EfraimManurung/instrumentation-system-fi2271/Laporan/sistem instrumentasi fix.pdf.docx

ALAT UKUR SUHU MENGGUNAKAN SENSOR THERMISTOR NTC BERBASIS MIKROKONTROLER ARDUINO UNO

Untuk memenuhi tugas Research Based Learning (RBL) mata kuliah FI2271 Sistem Instrumentasi

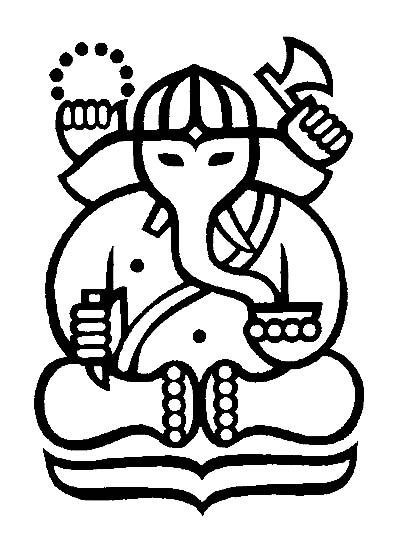
[picture p18: figure]

Anggi Maulana Adi S. | 10217040
Ahmad Al Ghiffari | 10217047
Efraim Partogi Nahotasi | 10217048

Program Studi Fisika

Fakultas Matematika dan Ilmu Pengethuan Alam Institut Teknologi Bandung

2018/2019

# Abstrak

Laporan Research Based Learning ini disusun dengan tujuan untuk menentukan rangkaian elektronika sistem kendali pemanas air beserta komponen yang menyusunnya. Metode yang digunakan dalam RBL ini memanfaatkan sensitifitas sensor thermistor NTC 10k terhadap perubahan suhu lingkungan disekitarnya. Selanjutnya didesain pengondisi sinyal sehingga menghasilkan keluaran 0-5V lalu dikonversi ke dalam sistem digital oleh mikrokontroler Arduino Uno. Sistem kontrol suhu menggunakan thermistor sebagai umpan balik dan heater sebagai plant system tersebut. Hasil dari percobaan RBL ini didapatkannya rangkaian yang bekerja dengan menyalakan heater sesuai dengan masukan suhu yang diberikan.

# Kata Kunci: Mikrokontroler, Heater, Pengondisi sinyal, PID, Termometer, Thermistor

# RANCANGAN BANGUN RANGKAIAN PENGONDISI SINYAL

Akan didesain dan dibangun alat ukur suhu dengan rentang suhu diantara 30 - 60 °C dan diperlukan sinyal tegangan keluaran dengan rentang 0 - 5V untuk dikonversi menjadi sinyal digital lalu diolah oleh mikrokontroler Arduino Uno. Untuk mendeteksi perubahan suhu lingkungan digunakan sensor thermistor NTC 10k yang dirangkai menjadi rangkaian jembatan dengan hambatan lainnya dengan nilai tertentu. Supply ke rangkaian jembatan ini diberikan oleh rangkaian pembagi tegangan antara sebuah resistor dan dioda zener 5.1V. Nilai resistor pada rangkaian jembatan dibuat sedemikian sehingga dihasilkan beda tegangan keluaran rangkaian jembatan sebesar 0 V pada suhu 30 °C. Untuk menguatkan sinyal keluaran dari rangkaian jembatan, digunakan penguat instrumentasi yang masuk ke mikrokontroler.

Pengolahan digital dilakukan oleh Arduino Uno. Dilakukan konversi sinyal analog ke sinyal digital (ADC) yang kemudian diolah untuk ditampilkan ke LCD; kontrol PID. PID diperlukan untuk mengatur daya pada plant pemanas (heater) sehingga suhu lingkungan (dalam hal ini air) dapat dipertahankan pada nilai titik acu (set point). Dalam kontrol suhu ini, mikrokontroler mendapatkan umpan balik (feedback) dari sensor.

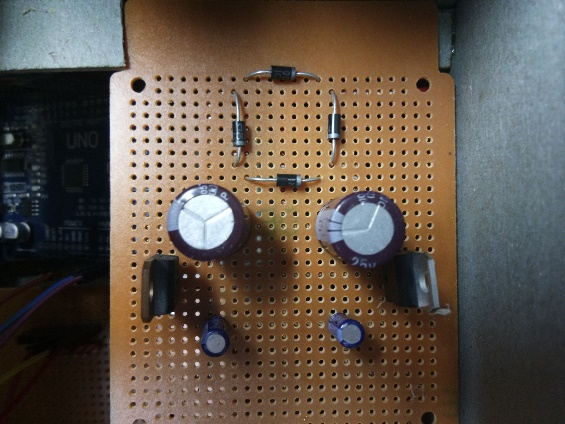
[picture p19: figure]

Gambar 1. Rangkaian Power Supply CT

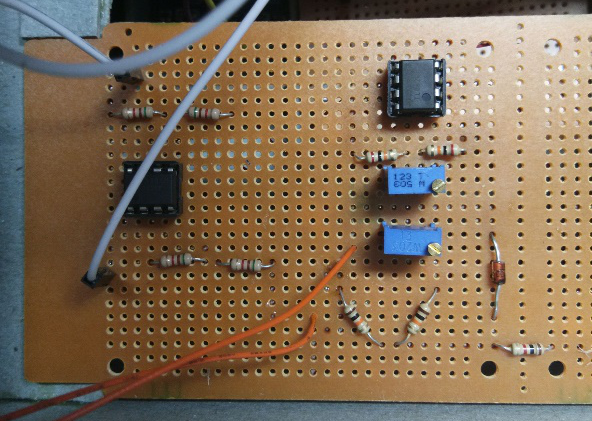
[picture p20: figure]

Gambar 2. Rangkaian Pengondisi Sinyal

# MODEL MATEMATIS RANGKAIAN SIGNAL CONDITIONING

Dalam rangkaian signal conditioning digunakan rangkaian jembatan dan penguat instrumentasi. Persamaan matematis pada rangkaian jembatan sebagai berikut.

Vb=(RPOTE)/(RPOTE+R2) Vreff (1)

Va=(RT)/(RT+R3)Vreff (2)

Dengan R2 = R3 dan mensubtitusikan persamaan 1 dan 2, diperoleh

Vab=Va-Vb=((RT)/(RT+R2)-(RPOTE)/(RPOTE+R2))Vreff (a)

Pada penguat Instrumentasi, persamaan matematis seperti berikut.

I1=(V1-Va)/(R4) (3)

I2=(Va-Vb)/(RPOT) (4)

I3=(Vb-V2)/(R5) (5)

Dari persamaan tersebut diperoleh I1 = I2 = I3, sehingga

I1=I2=I3=I=(Va-Vb)/(RPOT) (6)

Karena tidak ada arus yg masuk ke Op-Amp dan R4 = R5, maka

I=(V1-V2)/(2R4+RPOT)

V1-V2=I(2R4+RPOT) (7)

Substitusikan persamaan 6 dan 7, maka diperoleh

V1-V2=((2R4+RPOT))/(RPOT)(Va-Vb)

V1-V2=((2R4)/(RPOT)+1)(Va-Vb) (8)

Karena R4 = R5, maka dapat diperoleh

Vo=I (2R4+RPOT) (9)

Dengan melakukan substitusi pada persamaan 3 dan 4, diperoleh

Vo=(Vab)/(RPOT)(2R4+RPOT) (10)

Kemudian R6 = R7 = R8 = R9 dan pembagi tegangan, sehingga

(V+) =(V-)=(R6)/(R6+R6)V2=(V2)/2 (11)

I4 =(V1-(V-))/(R6)=(V1)/(R6)-(V2)/(2R6) (12)

I5 =((V-)-Vo)/(R6) (13)

Substitusikan persamaan 13 dan 11, diperoleh

I5 =(V2)/(2R6)-(Vo)/(R6) (14)

Kemudian karena I4 = I5, maka

(V1)/(R6)-(V2)/(2R6)=(V2)/(2R6)-(Vo)/(R6)

Vo=V2-V1 (15)

Selanjutnya substitusikan persamaan 15 dan 8, maka diperoleh

Vo=((2R4)/(RPOT)+1)(Vb-Va) (b)

# SKEMATIK RANGKAIAN

Penguat Instrumentasi yang digunakan yaitu TL082 dengan nilai Vcc masukan sebesar + 12 V. Heater dikontrol menggunakan PID dari Arduino Uno. Fitur hardware yang digunakan yaitu tampilan LCD dan pengatur suhu set (keypad).

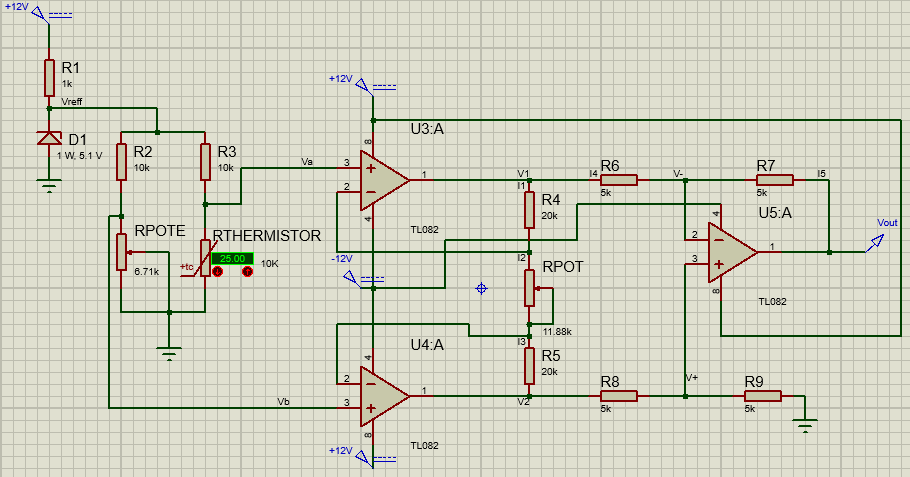
[picture p21: figure]

Gambar 3. Rangkaian menggunakan Thermistor NTC

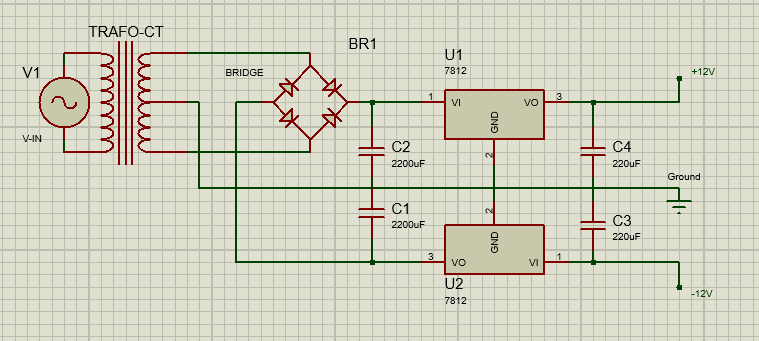
[picture p22: figure]

Gambar 4. Rangkaian Power Supply CT

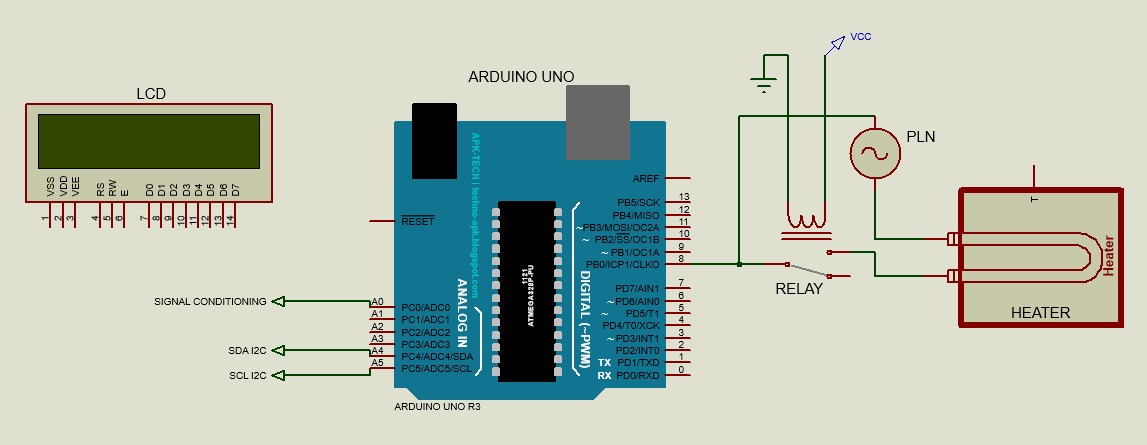
[picture p23: figure]

Gambar 5. Rangkaian Pin pada LCD I2C dan Plant dengan Arduino Uno.

# HASIL KALIBRASI SENSOR SUHU

Sensor thermistor NTC 10k dilakukan kalibrasi antara suhu terhadap nilai resistansi.

Tabel 1. Nilai Kalibrasi Suhu terhadap Resistansi pada Sensor NTC 10k

T (⁰C) | R (kꭥ) | T (⁰C) | R (kꭥ) | T (⁰C) | R (kꭥ)
30 | 9.95 | 40 | 6.77 | 50 | 4.72
31 | 9.52 | 41 | 6.59 | 51 | 4.55
32 | 9.26 | 42 | 6.31 | 52 | 4.4
33 | 8.98 | 43 | 6.09 | 53 | 4.24
34 | 8.5 | 44 | 5.85 | 54 | 4.1
35 | 8.33 | 45 | 5.77 | 55 | 3.92
36 | 7.94 | 46 | 5.44 | 56 | 3.75
37 | 7.55 | 47 | 5.24 | 57 | 3.7
38 | 7.31 | 48 | 5.11 | 58 | 3.564
39 | 7.09 | 49 | 4.9 | 59 | 3.43
| | | | 60 | 3.318

Selanjutnya dengan melakukan plot pada tabel 1, diperoleh persamaan hasil regresi nilai resistansi terhadap suhu sebagai berikut:

T = 0.3976(R)² - 9.6034(R) + 86.801

Gambar 6. Grafik Kalibrasi Suhu terhadap Resistansi pada Sensor suhu NTC 10k

# HASIL PENGUKURAN KELUARAN

Setelah sensor suhu telah terkalibrasi, kemudian dilakukan kalibrasi pada rangkaian bridge dan pengondisi sinyal. Dengan menentukan nilai resistansi sedemikian rupa pada rangkaian bridge dan pengondisi sinyal, diperoleh nilai tegangan keluaran terhadap suhu pada PCB sebagai berikut.

Tabel 2. Nilai Tegangan Keluaran pada Rangkaian Bridge di PCB

Suhu | Nilai | Suhu | Nilai | Suhu | Nilai
T ( °C ) | Vout (V) | T ( °C ) | Vout (V) | T ( °C ) | Vout (V)
29 | 0.06 | 40 | 0.63 | 51 | 0.99
30 | 0.2 | 41 | 0.67 | 52 | 1.01
31 | 0.26 | 42 | 0.71 | 53 | 1.03
32 | 0.32 | 43 | 0.73 | 54 | 1.06
33 | 0.34 | 44 | 0.75 | 55 | 1.09
34 | 0.41 | 45 | 0.74 | 56 | 1.11
35 | 0.42 | 46 | 0.82 | 57 | 1.17
36 | 0.41 | 47 | 0.83 | 58 | 1.18
37 | 0.39 | 48 | 0.87 | 59 | 1.2
38 | 0.45 | 49 | 0.89 | 60 | 1.22
39 | 0.58 | 50 | 0.96

## Gambar 7. Grafik Suhu Terhadap Tegangan Keluaran pada rangkaian bridge

Tabel 3. Nilai Tegangan Keluaran pada Rangkaian Pengondisi sinyal di PCB

Suhu | Nilai | Suhu | Nilai | Suhu | Nilai
T ( °C ) | Vout (V) | T ( °C ) | Vout (V) | T ( °C ) | Vout (V)
30 | 0.14 | 41.1 | 2.17 | 50.8 | 3.71
30.3 | 0.21 | 41.3 | 2.17 | 51.1 | 3.75
30.6 | 0.32 | 41.5 | 2.23 | 51.4 | 3.81
31.2 | 0.46 | 41.7 | 2.28 | 51.7 | 3.88
31.8 | 0.54 | 42.1 | 2.38 | 52 | 3.95
32.4 | 0.62 | 42.5 | 2.45 | 52.4 | 4.06
32.8 | 0.69 | 42.7 | 2.52 | 52.8 | 4.11
33.1 | 0.81 | 43.2 | 2.55 | 53.2 | 4.16
33.7 | 0.92 | 43.5 | 2.57 | 53.6 | 4.19
34 | 0.95 | 43.7 | 2.61 | 52.9 | 4.23
34.1 | 0.97 | 44.1 | 2.64 | 54.1 | 4.21
34.3 | 1 | 44.4 | 2.69 | 54.4 | 4.22
34.6 | 1.04 | 44.6 | 2.78 | 54.8 | 4.28
34.8 | 1.13 | 45.1 | 2.83 | 55 | 4.31
35.2 | 1.19 | 45.5 | 2.96 | 55.3 | 4.33
35.6 | 1.24 | 45.9 | 3.04 | 55.6 | 4.4
35.9 | 1.32 | 46.3 | 3.08 | 55.9 | 4.5
36.2 | 1.42 | 46.5 | 3.08 | 56.2 | 4.51
36.6 | 1.5 | 46.7 | 3.13 | 56.5 | 4.56
37.1 | 1.59 | 47.1 | 3.18 | 56.9 | 4.61
37.6 | 1.66 | 47.4 | 3.21 | 57.3 | 4.7
37.9 | 1.61 | 47.6 | 3.23 | 57.6 | 4.82
38.1 | 1.64 | 47.9 | 3.26 | 58 | 4.85
38.3 | 1.69 | 48.3 | 3.36 | 58.3 | 4.79
38.6 | 1.77 | 48.7 | 3.45 | 58.5 | 4.78
38.9 | 1.85 | 49 | 3.49 | 58.6 | 4.81
39.3 | 1.94 | 49.3 | 3.5 | 58.8 | 4.86
39.6 | 1.96 | 49.5 | 3.52 | 59 | 4.82
39.9 | 2.04 | 49.8 | 3.55 | 59.5 | 4.87
40.2 | 2.14 | 50 | 3.59 | 59.8 | 4.99
40.6 | 2.18 | 50.4 | 3.63 | 60.2 | 5.07

Selanjutnya dengan melakukan plot pada tabel 3, diperoleh persamaan suhu terhadap tegangan keluaran sebagai berikut:

## Gambar 8. Grafik Suhu Terhadap Tegangan Keluaran pada rangkaian pengondisi sinyal

## Gambar 9. Grafik Tegangan Keluaran Terhadap Suhu

# Plot Kenaikan Suhu terhadap Waktu dengan Nilai Kp 1.0

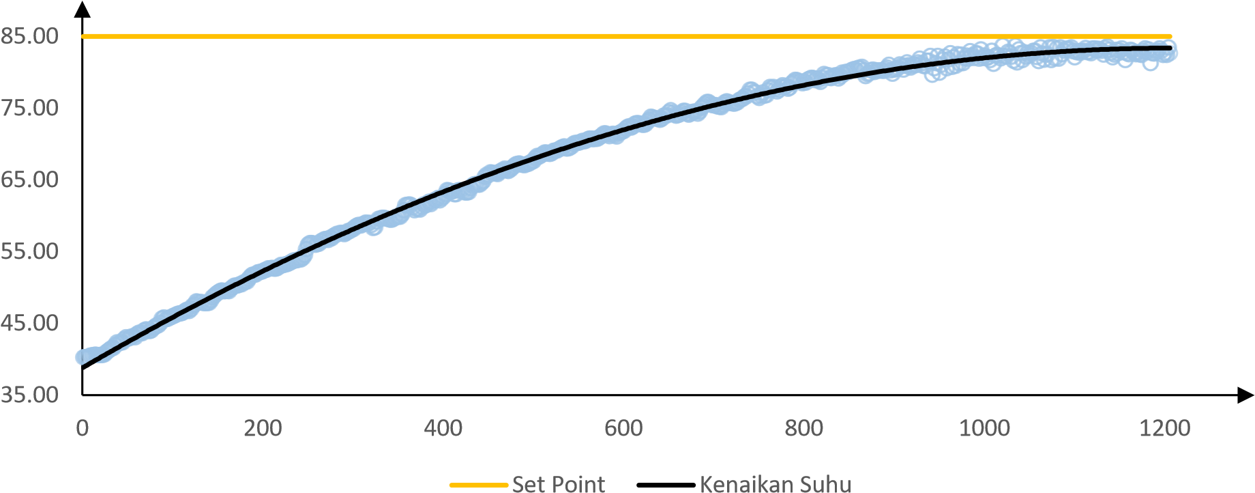
[picture p24: figure]

Gambar 10. Grafik suhu terhadap waktu

## Gambar 9. Grafik Temperatur terhadap waktu pada setpoint 35

## Gambar 9. Grafik Temperatur terhadap waktu pada setpoint 45

## Gambar 9. Grafik Temperatur terhadap waktu pada setpoint 55

Ketika melakukan pemanasan dan di set Kp, Ki, Kd, berturut-turut sebesar 1.0, 0.0, 0.0. tidak terjadi overshoot, namun suhu terukur tidak mencapai suhu acuan (suhu set), suhu terukur maksimum sebesar 83.34°C dari 85°C suhu yang dijadikan acuan. Nilai suhu terukur tersebut tercapai dalam waktu 1209 sekon dengan volume air sebesar 700 mL.

## ANALISIS

Analisis saat eksperimen PID dengan berbagai nilai Kp,Ki dan Kd dengan nilai window size yaitu sama sebesar 2000. Untuk yang pertama yaitu membuat setpoint pada 35 derajat celcius dan harus membuat error steady state nya dibawah 5% atau ± 1.75 derajat celcius dari hasil percobaan yang didapatkan nilai error steady state paling baik saat nilai Kp = 8 dan Kd = 0.5 yaitu sebesar 3.7% atau ± 1.3 derajat celcius. Untuk nilai Kp = 8 tanpa Kd didapatkan overshot begitu besar hingga berbeda 3 derajat celcius dari nilai setpoint, saat nilai Kp = 6 tanpa Kd didapatkan tidak pernah mencapai overshot. Untuk yang kedua yaitu setpoint pada 45 derajat celcius dan harus membuat error steady state nya dibawah 5% atau ± 2.25 derajat celcius dari hasil percobaan yang didapatan nilai error steady state paling baik saat nilai Kp = 7, Ki = 0.1 dan Kd = 0.5 yaitu sebesar 3.3% atau ± 1.485 derajat celcius. Saat nilai Kp = 9,Ki = 0.1 dan Kd = 1 akan terjadi overshot sebesar 3 derajat yang berarti sudah diluar batas error steady state dan saat nilai Kp = 7.5 Ki =0.1 dan Kd = 0.5 nilai temperatur akan diam pada nilai 47. Untuk yang ketiga yaitu setpoint pada 55 derajat celcius dan harus membaut error steady state nya dibawah 5% atau ± 2.75 derajat celcius, dari hasil percobaan didapatkan nilai paling error steady state paling baik saat Kp = 15,5 Ki =0.5 dan Kd = 1 dengan nilai error steady state sebesar 1.69% atau ± 0.93 derajat celcius. Untuk variasia nilai lain Kp = 14 Ki = 0.5 dan Kd = 1 didapatkan nilai overshot sebesar 3 derajat celcius dengan waktu rise time yang cukup lama, lalu dengan percobaan yang lain dengan Kp = 16 terdapat fluktuasi nilai temperatur yang sangat tinggi dan juga tidak mencapai nilai setpoint.

Dari hasil kalibrasi pada pengondisi sinyal, nilai tegangan keluaran menggunakan proteus berbeda dengan tegangan keluaran yang sebenarnya. Ketika 40°C nilai tegangan keluaran bernilai negatif dan ketika 85°C nilai tegangan keluaran lebih dari 5 V yang artinya hasil keluaran tidak terbaca oleh program Arduino Uno. Nilai tegangan keluaran ditampilkan pada LCD hanya pada suhu antara 40°C – 86°C, nilai ini didapatkan karena dilakukan perubahan nilai konstanta pada persamaan (c) di dalam source code Arduino. Hal ini disebabkan oleh tegangan masukan yang diberikan dari dioda zener yang berfluktuasi pada nilai 5,12 – 5,20 V. Selain itu, ketika melakukan kalibrasi, kecepatan pembacaan voltmeter berbeda dengan kalibrator yang digunakan saat suhu naik dari 40°C, bacaan pada voltmeter berubah lebih lambat dibanding kalibrator suhu.

Nilai akurasi suhu yang ada di tampilan LCD dengan tampilan kalibrator berbeda + 0.5°C (rentang ini merupakan selisih nilai alat ukur dengan kalibrator; disebabkan karena ketelitian kalibrator hanya 1°C) dengan nilai di tampilan LCD lebih besar dibandingkan dengan di tampilan kalibrator. Kesamaan nilai tampilan alat ukur dengan kalibrator berkurang saat suhu mendekati titik acu yang digunakan.

## KESIMPULAN

Dari hasil percobaan pada variasi nilai yang digunakan pada PID untuk nilai setpoint kecil seperti rentang 30 hingga 35 cukup susah untuk mencapai nilai steady state error dibawah 5% dikarenakan nilai skala yang cukup kecil yaitu hanya sebesar 5 derajat celcius dari hasil eksperimen didapatkan sebesar 3.7% , untuk set point 45 didapatkan nilai steady state error sebesar 3.3% , dan yang terakhir untuk setpoint 55 derajat celcius dengan skala yang cukup besar maka bisa didapatkan nilai error steady state semakin baik dari hasil eksperimen didapatkan sebesar 1.69%.

Telah dibuat alat ukur suhu menggunakan sensor thermistor NTC 10 kΩ, alat ini bekerja pada rentang suhu sebesar 30°C - 60°C. Galat suhu antara alat ukur dengan kalibrator sebesar ± 0.5°C. Ketika nilai Kp, Ki, Kd diatur dengan nilai berturut-turut 1.0, 0.0, dan 0.0 dengan titik acu 85 °C didapatkan nilai maksimum yang terbaca oleh alat ukur adalah 83.34°C dengan rentang waktu selama 1209 sekon. Dari hasil uji alat ukur suhu diperoleh nilai akurasi sebesar 0.38°C/V.

## REFERENSI

[1] Anonim. TT. Thermistor. https://www.thermistor.com/thermistors. Diakses pada 16 April 2019 jam 09.28 WIB.
[2] Anonim. TT. Thermistors. https://www.electronics (https://www.electronics-tutorials.ws/io/thermistors.html)- (https://www.electronics-tutorials.ws/io/thermistors.html)tutorials.ws/io/thermistors.html. (https://www.electronics-tutorials.ws/io/thermistors.html) Diakses pada 16 April 2019 jam 09.30 WIB.
[3] Justin Bauer. 2015. Design of an Instrumentation Amplifier. [pdf]. https://www.electronics (https://www.electronics-tutorials.ws/io/thermistors.html) (https://www.electronics-tutorials.ws/io/thermistors.html)tutorials.ws/io/thermistors.html. (https://www.electronics-tutorials.ws/io/thermistors.html) Diunduh pada 15 April 2019 jam 09. 40 WIB.
[4] Prof. Katherine Chandler. 2012. Operational Amplifiers (Op Amps). [pdf]. www.eng.hmc.edu/NewE80/PDFs/Lecture%205%20- (http://www.eng.hmc.edu/NewE80/PDFs/Lecture%205%20-%20Op%20Amps.pdf)%20Op%20Amps.pdf (http://www.eng.hmc.edu/NewE80/PDFs/Lecture%205%20-%20Op%20Amps.pdf) (http://www.eng.hmc.edu/NewE80/PDFs/Lecture%205%20-%20Op%20Amps.pdf). Diakses pada 12 April 2018.
[5] Anonim. TT. Arduino Uno. http://www.tuxti.com.br/wiki/index.php?title=Arquivo:CircuitoArduino-i2c-display-lcd-16x2.png. Diakses pada 16 April 2018 jam 14.24 WIB.

## Daftar Simbol

R1 = 1 kΩ

R2 = R3 = 2 kΩ

RPOTE = 6,71 kΩ

R4 = R5 = 20 kΩ

RPOT = 11,88 kΩ

R6 = R7 = R8 = R9 = 5 kΩ

RT | = Resistansi pada Thermistor NTC 10K (Ω)
Va | = Tegangan yang ada di titik antara RT dan R3 (V)
Vb | = Tegangan yang ada di titik antara RPOT dan R2 (V)
V1 | = Tegangan yang ada di titik antara R4 dan R6 (V)
V2 | = Tegangan yang ada di titik antara R5 dan R8 (V)
Vo | = Tegangan keluaran (V)

## LAMPIRAN

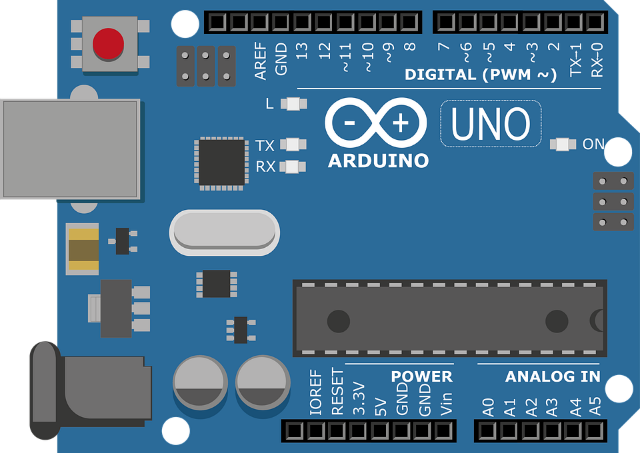
[picture p25: figure]

Gambar 11. Arduino Uno

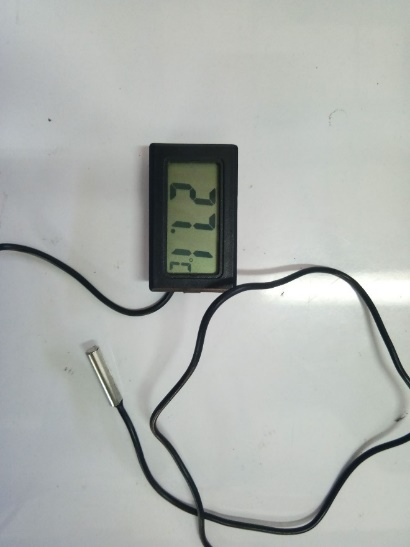
[picture p26: figure]

Gambar 12. Termometer

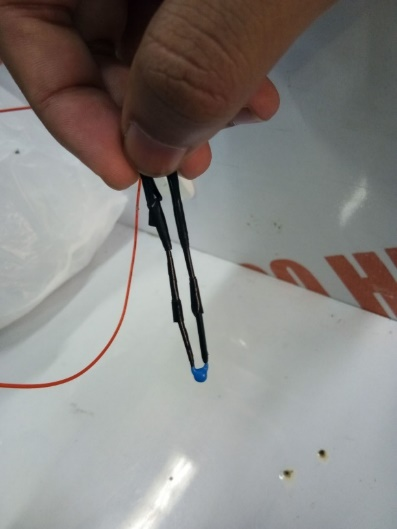
[picture p27: figure]

Gambar 13. Thermistor NTC 10k

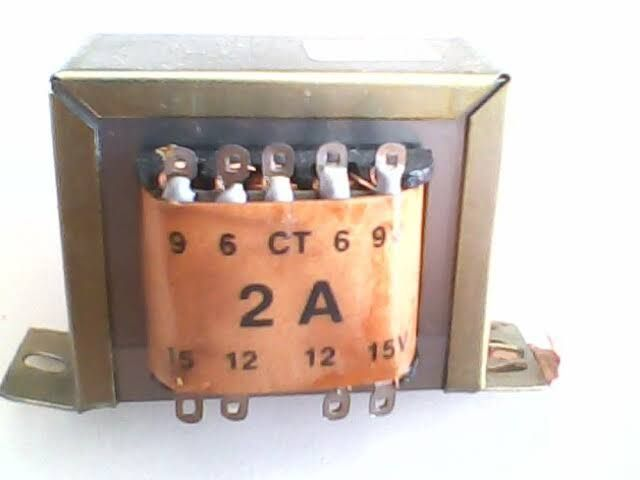
[picture p28: figure]

Gambar 14. Trafo CT

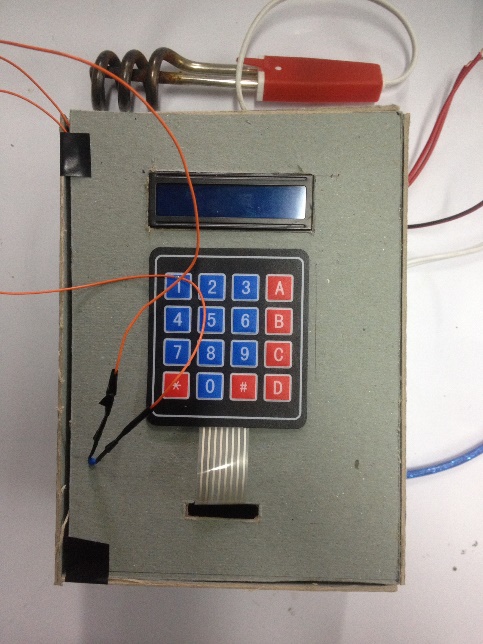
[picture p29: figure]

Gambar 15. Heater, LCD, keypad yang digunakan

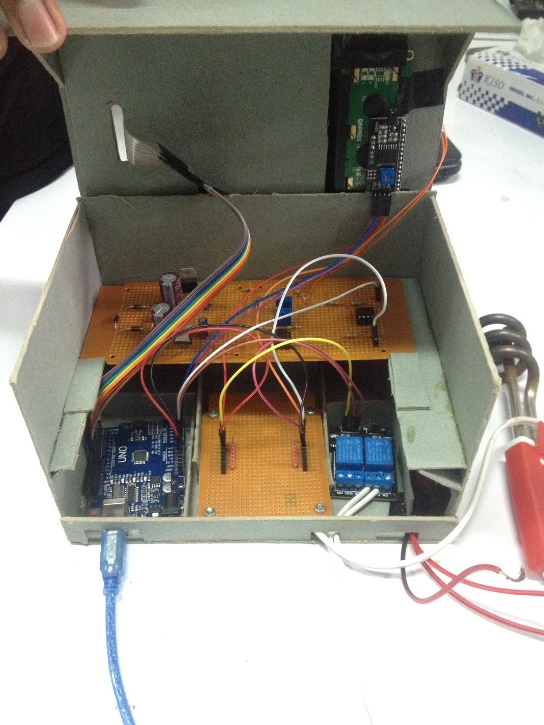
[picture p30: figure]

Gambar 16. Komponen yang terdapat didalam kotak

### Source Code Arduino Uno

// Deklarasi Library yang digunakan

#include <Wire.h>

#include <LiquidCrystal_I2C.h>

#include <Keypad.h>

#include <avr/pgmspace.h>

#include <PID_v1.h>

// Inisiasi variabel yang digunakan

const int sensorthermi = A0;

double resultPID;

double tempc;

double temps;

float Ton, Toff;

char InTemp[2];

unsigned long previousMillis1 = 0;

unsigned long previousMillis2 = 0;

unsigned long previousMillis3 = 0;

unsigned long previousMillis4 = 0;

const long interval1 = 2000;

const long interval2 = 2000;

const long interval3 = 500;

const long interval4 = 1000;

unsigned long PTexcel, PTdisplay, PTmeasure = 0;

unsigned long CTexcel, CTdisplay, CTmeasure = 0;

unsigned long ITexcel = 1000;

unsigned long ITdisplay = 666;

unsigned long ITmeasure = 100;

// SMOOTHING

const int numReadings = 10;

int readings[numReadings]; // the readings from the analog input

int readIndex = 0; // the index of the current reading

int total =0;

int average = 0; // the average

// Menginisiasi nilai lookup tabel dengan skala 0-5 V secara teoritik

const float ADC_TO_TEMP[1024] PROGMEM = {27.7555, 27.7859, 27.8164, 27.8469, 27.8773, 27.9078, 27.9382, 27.9687, 27.9992, 28.0296, 28.0601, 28.0906, 28.121, 28.1515, 28.1819, 28.2124, 28.2429, 28.2733, 28.3038, 28.3343, 28.3647, 28.3952, 28.4257, 28.4561, 28.4866, 28.517, 28.5475, 28.578, 28.6084, 28.6389, 28.6694, 28.6998, 28.7303, 28.7607, 28.7912, 28.8217, 28.8521, 28.8826, 28.9131, 28.9435, 28.974, 29.0044, 29.0349, 29.0654, 29.0958, 29.1263, 29.1568, 29.1872, 29.2177, 29.2482, 29.2786, 29.3091, 29.3395, 29.37, 29.4005, 29.4309, 29.4614, 29.4919, 29.5223, 29.5528, 29.5832, 29.6137, 29.6442, 29.6746, 29.7051, 29.7356, 29.766, 29.7965, 29.827, 29.8574, 29.8879, 29.9183, 29.9488, 29.9793, 30.0097, 30.0402, 30.0707, 30.1011, 30.1316, 30.162, 30.1925, 30.223, 30.2534, 30.2839, 30.3144, 30.3448, 30.3753, 30.4058, 30.4362, 30.4667, 30.4971, 30.5276, 30.5581, 30.5885, 30.619, 30.6495, 30.6799, 30.7104, 30.7408, 30.7713, 30.8018, 30.8322, 30.8627, 30.8932, 30.9236, 30.9541, 30.9845, 31.015, 31.0455, 31.0759, 31.1064, 31.1369, 31.1673, 31.1978, 31.2283, 31.2587, 31.2892, 31.3196, 31.3501, 31.3806, 31.411, 31.4415, 31.472, 31.5024, 31.5329, 31.5633, 31.5938, 31.6243, 31.6547, 31.6852, 31.7157, 31.7461, 31.7766, 31.807, 31.8375, 31.868, 31.8984, 31.9289, 31.9594, 31.9898, 32.0203, 32.0508, 32.0812, 32.1117, 32.1421, 32.1726, 32.2031, 32.2335, 32.264, 32.2945, 32.3249, 32.3554, 32.3858, 32.4163, 32.4468, 32.4772, 32.5077, 32.5382, 32.5686, 32.5991, 32.6296, 32.66, 32.6905, 32.7209, 32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
8.4622, 58.4927, 58.5231, 58.5536, 58.5841, 58.6145, 58.645, 58.6754, 58.7059, 58.7364, 58.7668, 58.7973, 58.8278, 58.8582, 58.8887, 58.9191}

;

// Alamat LCD

LiquidCrystal_I2C lcd(0x27,2,1,0,4,5,6,7,3, POSITIVE);

// Menginisiasi nilai kolom dan baris yang digunakan

const byte ROWS = 4; //Define amount of Rows

const byte COLS = 4; //Define amount of Columns

char hexaKeys[ROWS][COLS] = { //Define Keypad layout

{'1', '2', '3', 'A'},

{'4', '5', '6', 'B'},

{'7', '8', '9', 'C'},

{'*', '0', '#', 'D'}

};

byte rowPins[ROWS] = {9, 8, 7, 6}; //Pins for Keypad Input

byte colPins[COLS] = {5, 4, 3, 2};

Keypad myKeypad = Keypad(makeKeymap(hexaKeys), rowPins, colPins, ROWS, COLS);

// Setup for PID

double Setpoint, Input, Output;

double Kp=5.0, Ki=3.0, Kd=3.0;

const int Relay = A1;

PID myPID(&Input, &Output, &Setpoint, Kp , Ki, Kd, DIRECT);// Kpnya dulu dimainkan agar mendapatkan rise time yang paling cepat

//PID myPID(&Input, &output, &setpoint, Kp, Ki, Kd, Direction);

int WindowSize = 2000;

unsigned long windowStartTime;

void setup() {

Serial.begin(9600);

// Setup untuk PID

windowStartTime = millis();

myPID.SetOutputLimits(0, WindowSize);

myPID.SetMode(AUTOMATIC);

// Untuk smoothing

for (int thisReading = 0; thisReading < numReadings; thisReading++) {

readings[thisReading] = 0;}

// Menginisiasi LCD

lcd.begin(16,2);

lcd.backlight();

lcd.clear();

lcd.setCursor(0,0);

pinMode(A0, INPUT);

pinMode(A1, OUTPUT);

// Persiapan

lcd.print("READY");

}

void loop() {

unsigned long currentMillis1 = millis(); // Syarat agar keypad selalu dapat menerima nilai masukan

if (currentMillis1 - previousMillis1 >= interval1) { previousMillis1 = currentMillis1;

// Mencari nilai rata-rata masukan ADC

// subtract the last reading:

total = total - readings[readIndex];

// read from the sensor:

readings[readIndex] = analogRead(sensorthermi);

// add the reading to the total:

total = total + readings[readIndex];

// advance to the next position in the array:

readIndex = readIndex + 1;

// if we're at the end of the array...

if (readIndex >= numReadings) {

// ...wrap around to the beginning:

readIndex = 0;

}

// calculate the average:

average = total / numReadings;

// mengkonversi tegangan yang dibaca untuk ditampilkan pada serial monitor

float voltage = average * 5.0;

voltage /= 1024.0; }

// memunculkan nilai tegangan pada serial monitor

//Serial.print(voltage); Serial.println(" volts"); }

// PENGAMBILAN

// melakukan fungsi lookup table dengan data lookup tabel yang sudah dinisiasikan

unsigned long currentMillis2 = millis(); // Syarat agar keypad selalu dapat menerima nilai masukan

if (currentMillis2 - previousMillis2 >= interval2) { previousMillis2 = currentMillis2;

tempc = pgm_read_float_near (ADC_TO_TEMP + average);

Serial.println(tempc);//Serial.println(" derajat celcius"); // menulis nilai keluaran

//Serial.print("nilai bit rata-rata : "); Serial.println(average); // dimunculkan pada serial monitor

//Serial.println(); Serial.println();

//Serial.print(" temps : ");Serial.println(temps);

// MENAMPILKAN NILAI CURRENT TEMPERATURE DAN SET TEMPERATURE PADA DISPLAY

lcd.setCursor(0,0); // we start writing from the first row first column

lcd.print("TCur : ");lcd.print(tempc);lcd.print((char)223);lcd.print("C"); // Mengeluarkan nilai temperatur saat ini pada LCD

lcd.setCursor(0,1);

lcd.print("TSet : ");lcd.print(temps); lcd.print((char)223);lcd.print("C"); // Mengeluarkan nilai temperatur yang akan di set

}

// MENGAMBIL MASUKAN Temps DARI KEYPAD, belum dimasukkan nilai temps nya!

unsigned long currentMillis3 = millis(); // Syarat agar keypad selalu dapat menerima nilai masukan

if (currentMillis3 - previousMillis3 >= interval3) { previousMillis3 = currentMillis3;

char Key = myKeypad.getKey();

if (Key == 'A'){ //When "Enter" button is pushed

lcd.clear();

lcd.setCursor(0,0);lcd.print("Target Temp : "); //Output LCD top bar

lcd.setCursor(0,1);lcd.print(temps); //Output LCD bottom bar

KeyInput: //Goto start of KeyInput

lcd.setCursor(0,1);lcd.print(" "); //Clear bottom line

int data_count = 0; //Reset data_count

do{

Key = myKeypad.getKey(); //Get Key from Keypad

if (isdigit(Key)){ //Check for input

InTemp[data_count] = Key; //Get input into char array

lcd.setCursor(data_count,1);lcd.print(InTemp[data_count]); //Output Key on lCD

data_count++;

}

}while(data_count < 2);

temps = atoi(InTemp); //Convert Char array to Integer

if (temps > 60 || temps <30) { //Check for invalid input

lcd.setCursor(0,1);lcd.print("ERROR");

;

goto KeyInput;

} ; }; char Key2 = myKeypad.getKey(); if (Key == 'B') {lcd.clear();};

}

CTexcel = millis();

if (CTexcel - PTexcel >= ITexcel) {

Serial.print("DATA, ");

Serial.print(tempc);

Serial.print(",");

Serial.print("TIMER");

Serial.print(",");

Serial.println();

// SETUP PID sesuai dengan library

myPID.Compute();

Input = (int)(((tempc - 27.75555)/31.1636)*1024);

Setpoint = (int)(((temps - 27.75555)/31.1636)*1024);

if (millis() - windowStartTime > WindowSize)

{ //time to shift the Relay Window

windowStartTime += WindowSize;

}

if ( Output < millis() - windowStartTime) digitalWrite(Relay, HIGH);

else digitalWrite(Relay, LOW); Serial.println(Output);

}

}
